WILLIAM04052005/Projet-Bateau-autopilot-2024-2026-/docs/rapports/annee-1_2024-2025/eee-synthese-simulations.pdf

# synthesis diagram and simulations of analog controls 1-SIMULATION OF MOTOR CONTROL

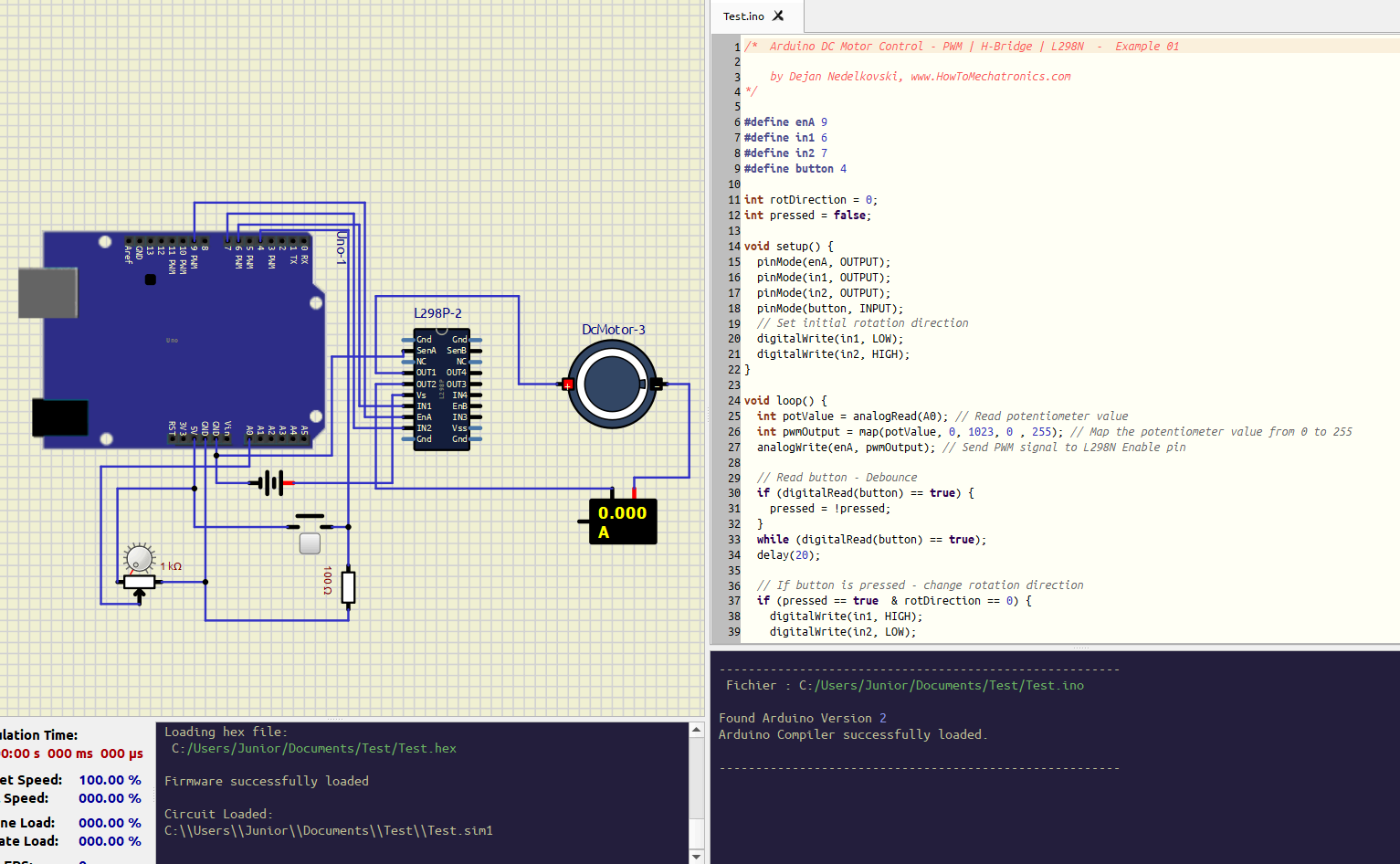
[picture p67: figure]
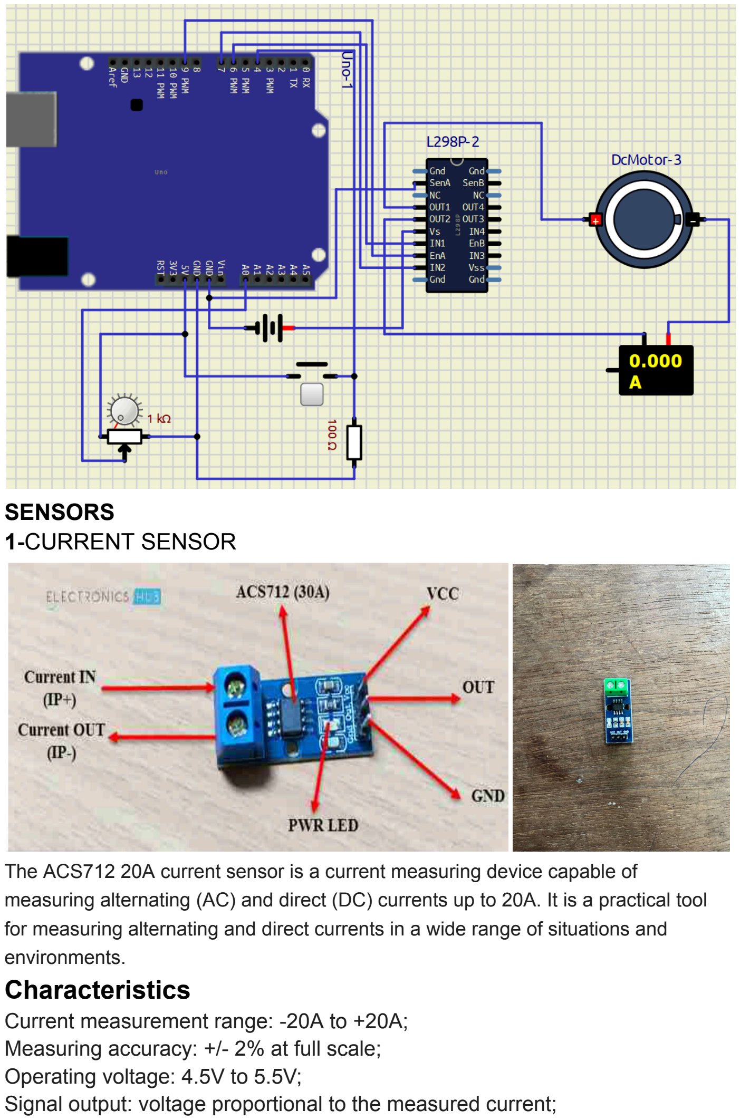
[picture p68: page 2]

SENSORS
1-CURRENT SENSOR

The ACS712 20A current sensor is a current measuring device capable of measuring alternating (AC) and direct (DC) currents up to 20A. It is a practical tool for measuring alternating and direct currents in a wide range of situations and environments.

## Characteristics

Current measurement range: -20A to +20A;
Measuring accuracy: +/- 2% at full scale;
Operating voltage: 4.5V to 5.5V;
Signal output: voltage proportional to the measured current;

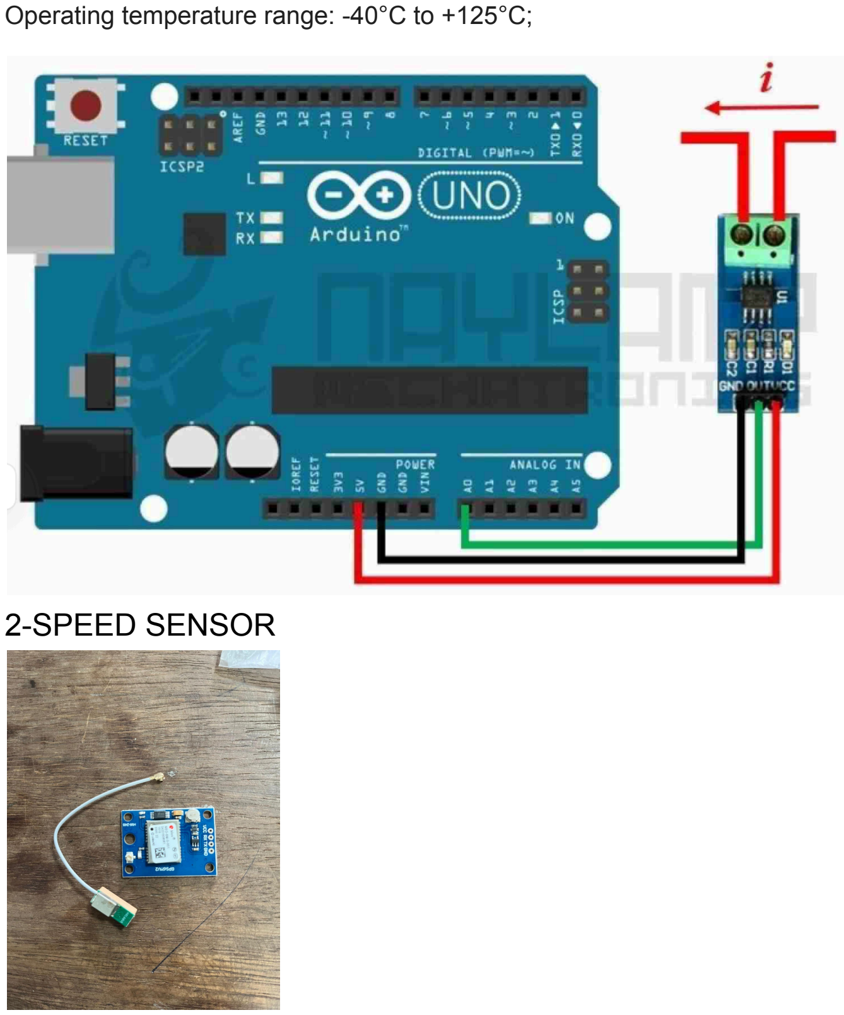
[picture p69: page 3]

Operating temperature range: -40°C to +125°C;

## 2-SPEED SENSOR
