WILLIAM04052005/Projet-Bateau-autopilot-2024-2026-/media/images/annee-1/eee-chaines-commande-information.jpg

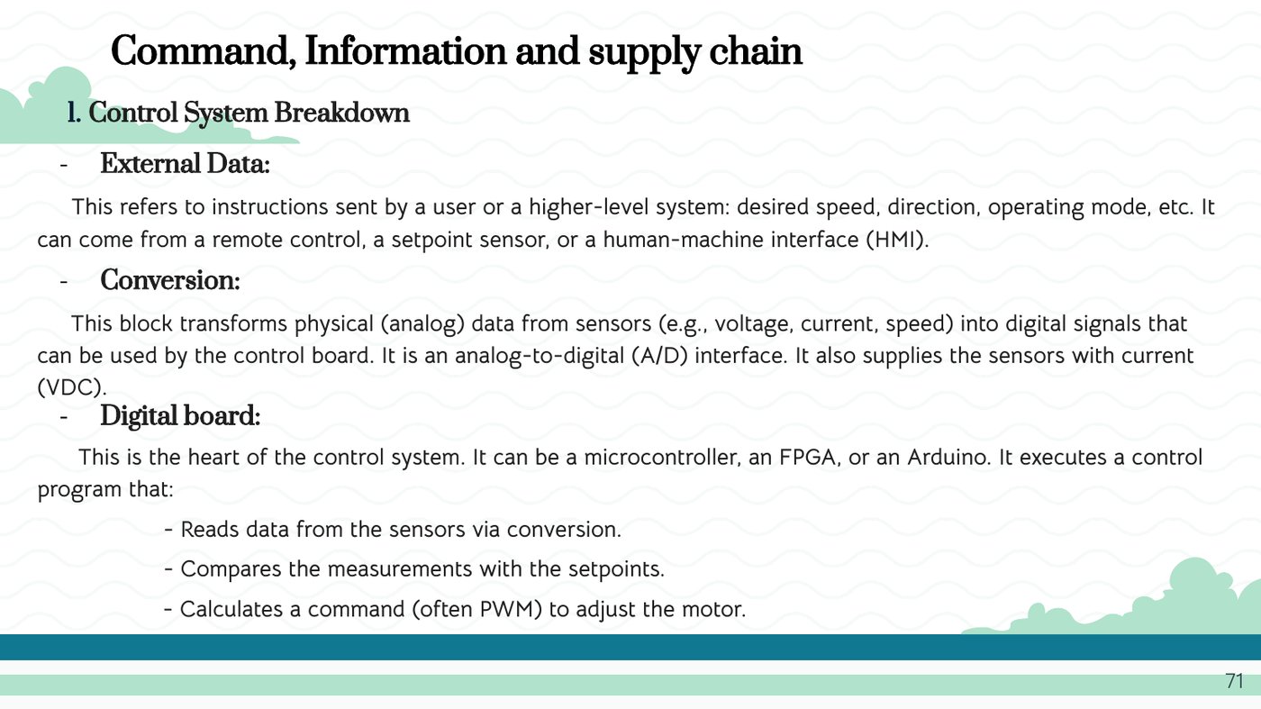
media/images/annee-1/eee-chaines-commande-information.jpg
