WILLIAM04052005/Projet-Bateau-autopilot-2024-2026-/media/images/annee-1/eee-systeme-automatise-arduino.jpg

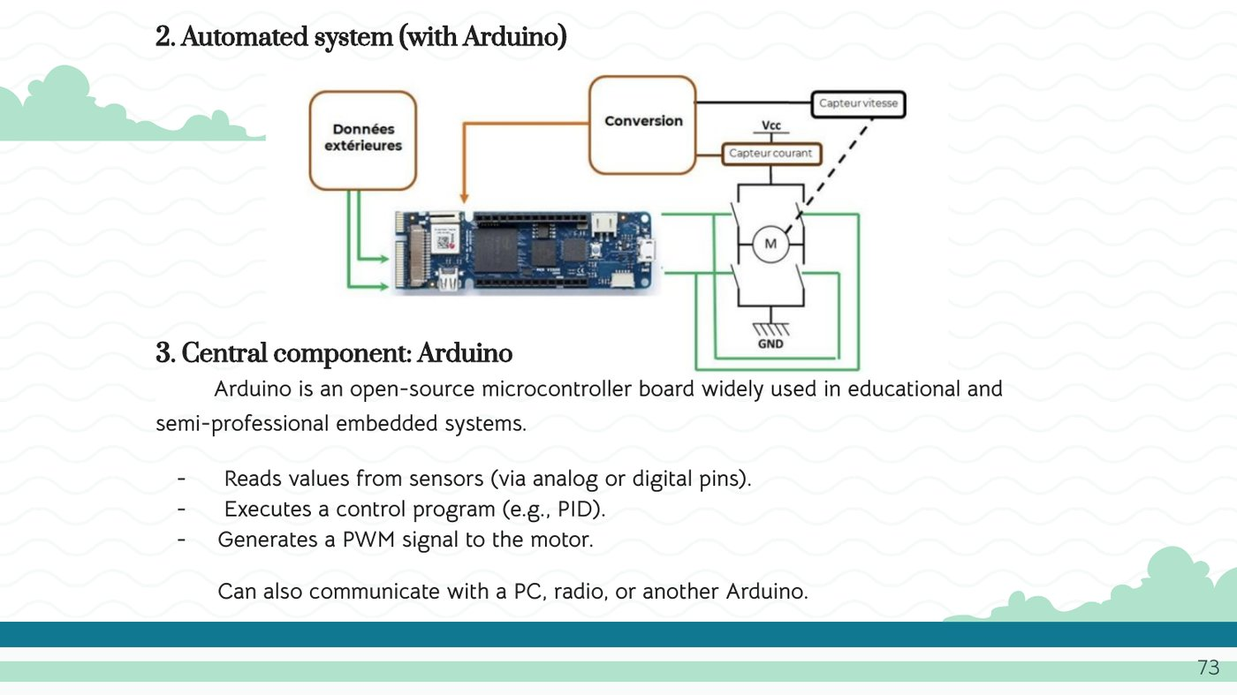
media/images/annee-1/eee-systeme-automatise-arduino.jpg
