WILLIAM04052005/Projet-Bateau-autopilot-2024-2026-/media/images/annee-1/mia-cablage-autopilote.jpg

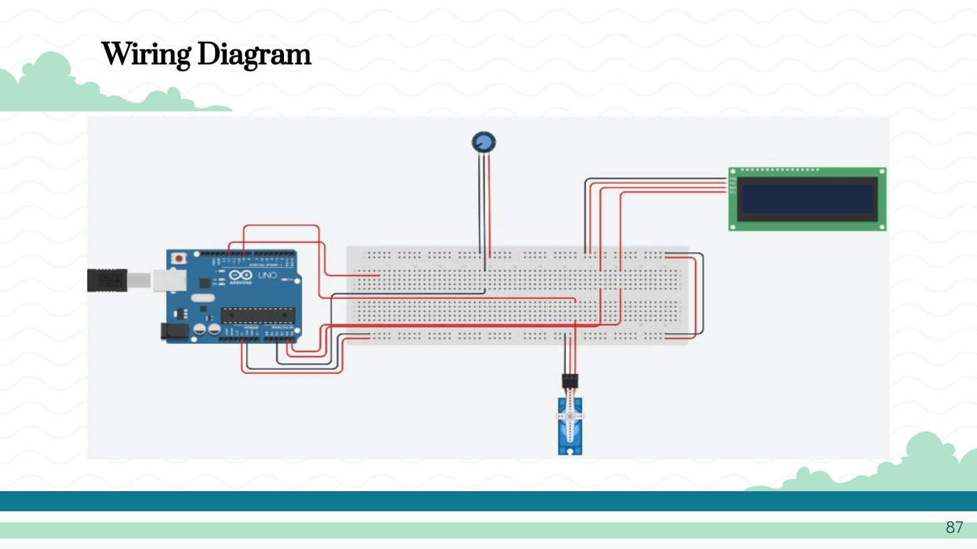
media/images/annee-1/mia-cablage-autopilote.jpg
