WILLIAM04052005/Projet-Bateau-autopilot-2024-2026-/media/images/annee-2/app-inventor-motor-direction.png

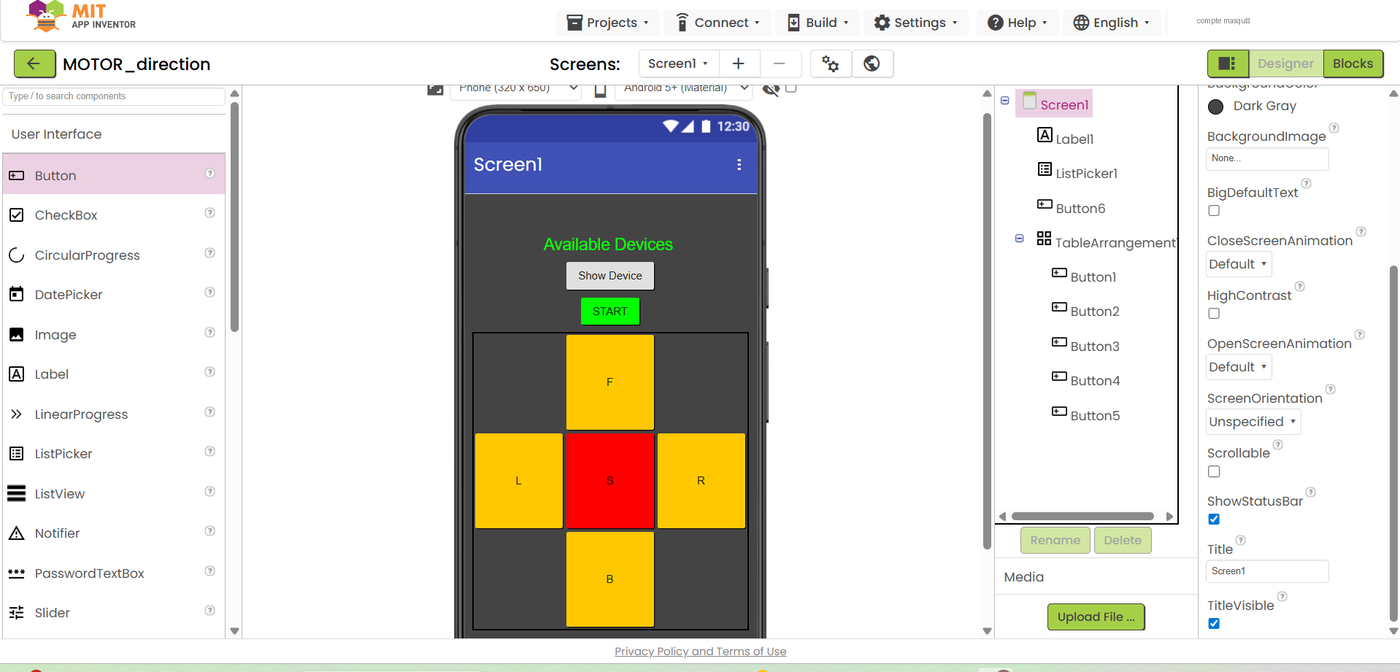
media/images/annee-2/app-inventor-motor-direction.png
