WILLIAM04052005/Projet-Bateau-autopilot-2024-2026-/media/images/annee-2/eee-blocs-fonctionnels.png

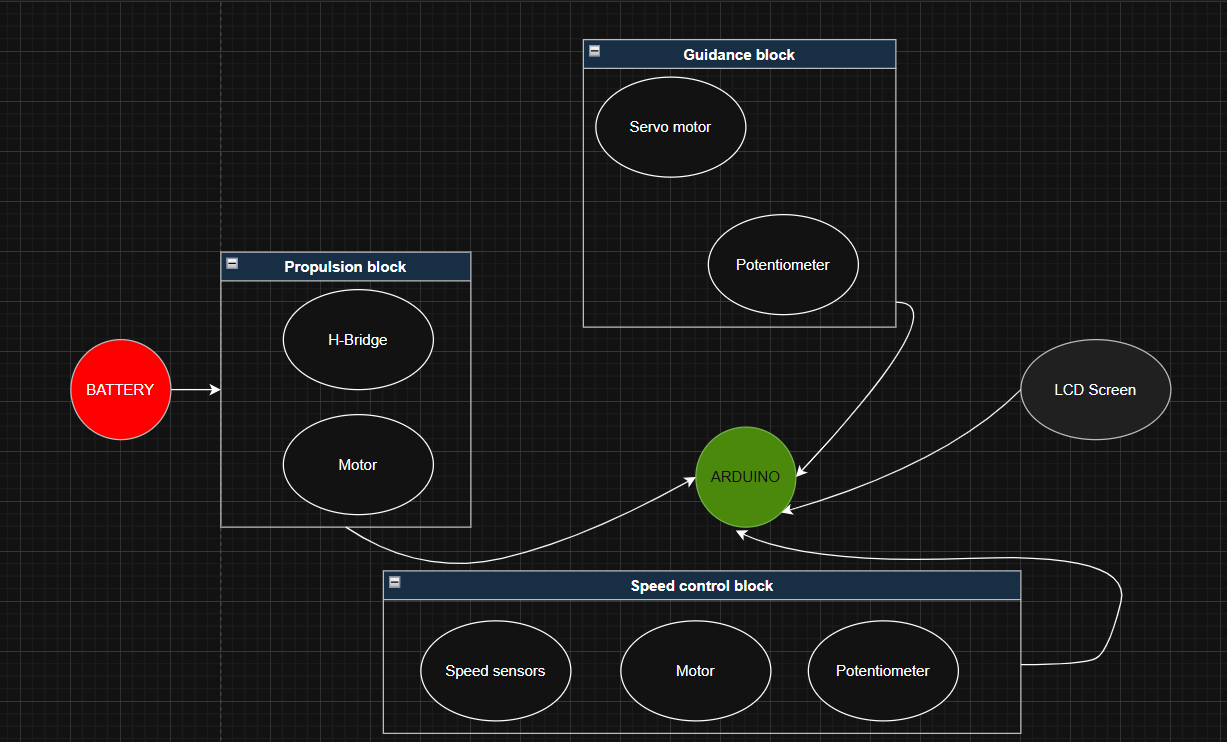
media/images/annee-2/eee-blocs-fonctionnels.png
