WILLIAM04052005/Projet-Bateau-autopilot-2024-2026-/media/images/annee-2/interface-web-reelle-2.png

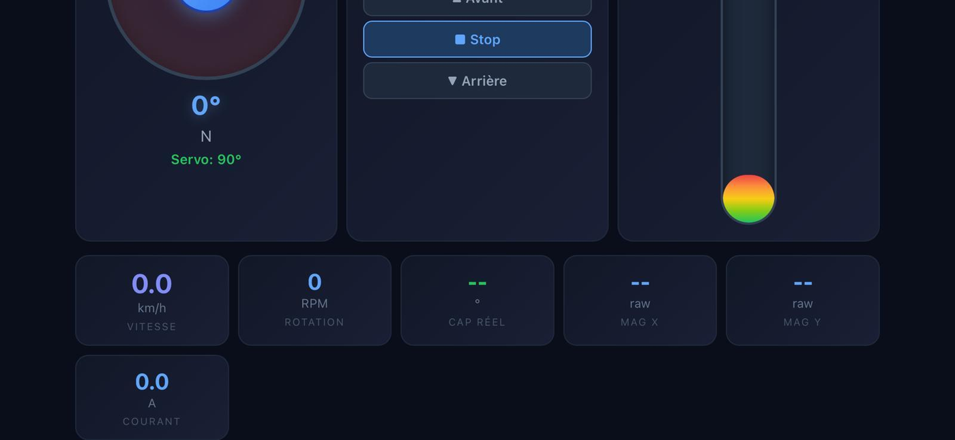
media/images/annee-2/interface-web-reelle-2.png
