WILLIAM04052005/Projet-Bateau-autopilot-2024-2026-/media/images/annee-2/moule-reutilise-potager.jpg

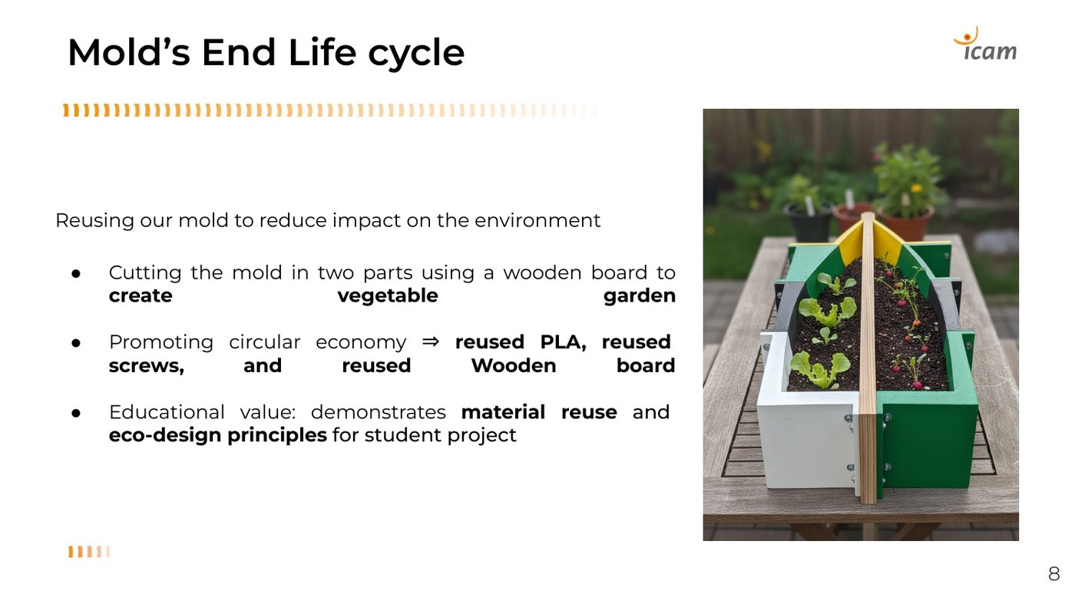
media/images/annee-2/moule-reutilise-potager.jpg
