WILLIAM04052005/Projet-Bateau-autopilot-2024-2026-/media/images/annee-2/pont-h-bts7960.jpg

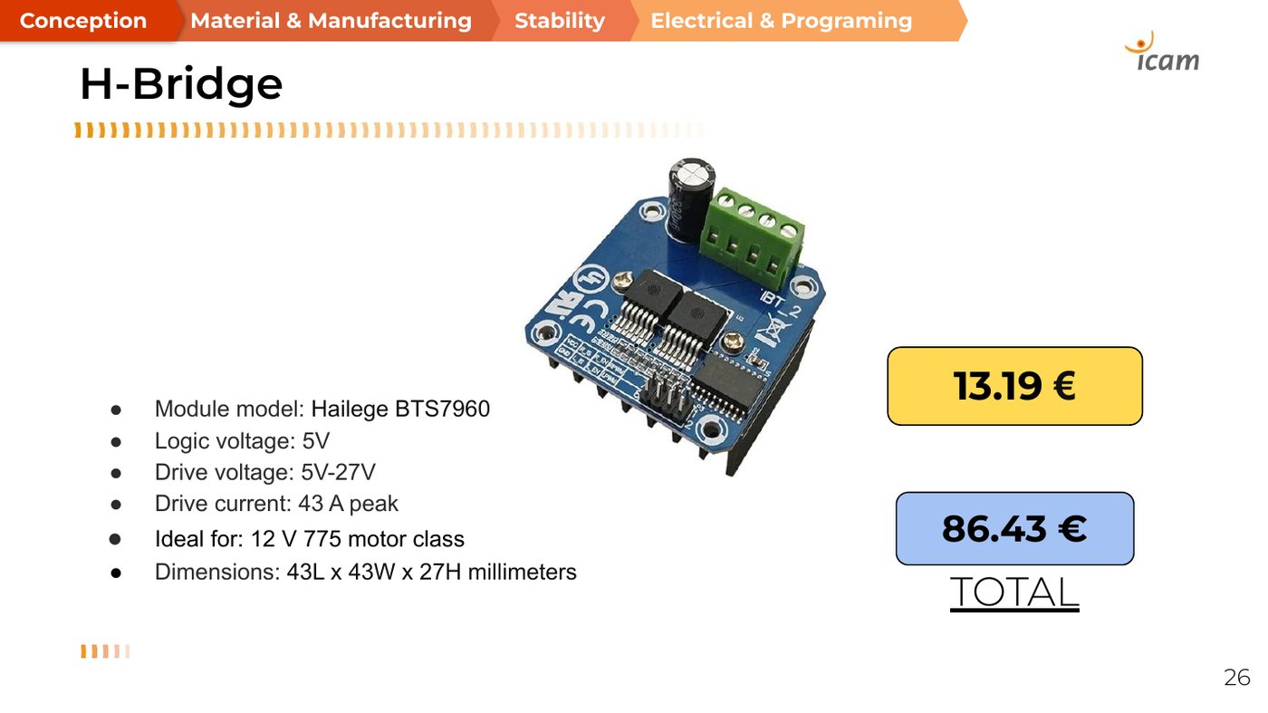
media/images/annee-2/pont-h-bts7960.jpg
