WILLIAM04052005/Projet-Bateau-autopilot-2024-2026-/media/photos/atelier-composite.jpg

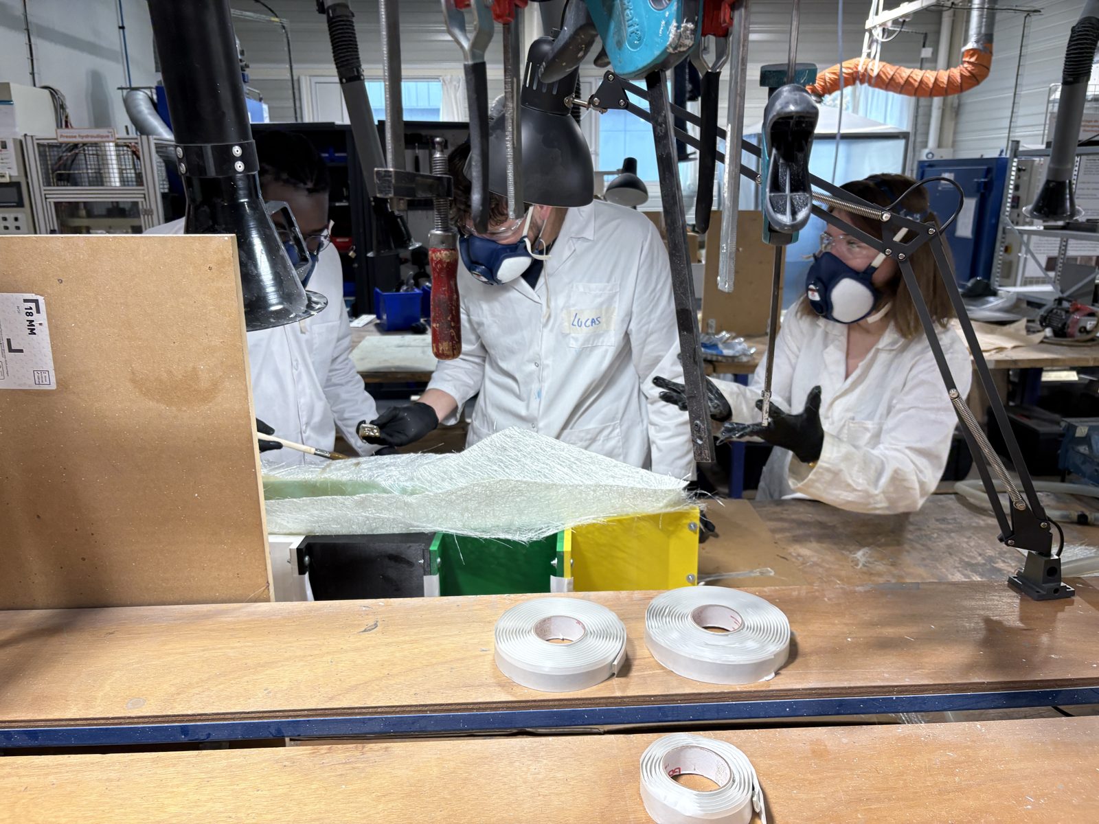
media/photos/atelier-composite.jpg
