WILLIAM04052005/Projet-Bateau-autopilot-2024-2026-/media/photos/coque-support-arriere.jpg

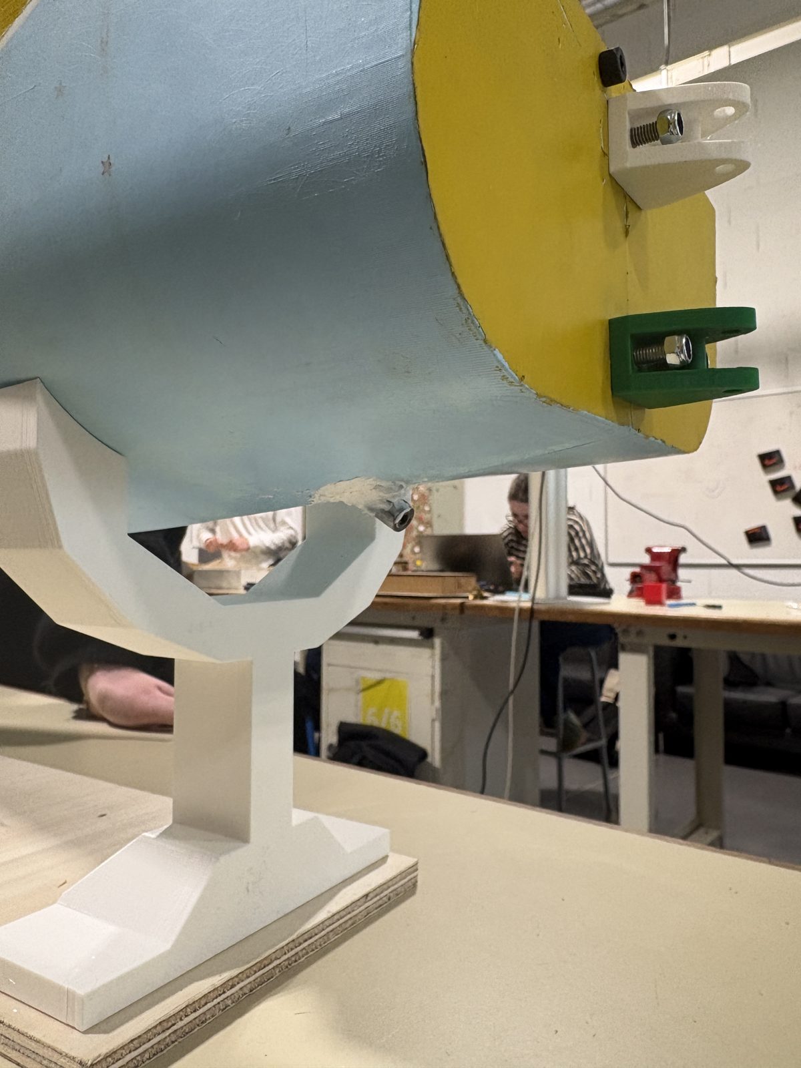
media/photos/coque-support-arriere.jpg
