WILLIAM04052005/Projet-Bateau-autopilot-2024-2026-/media/photos/interface-telephone.jpg

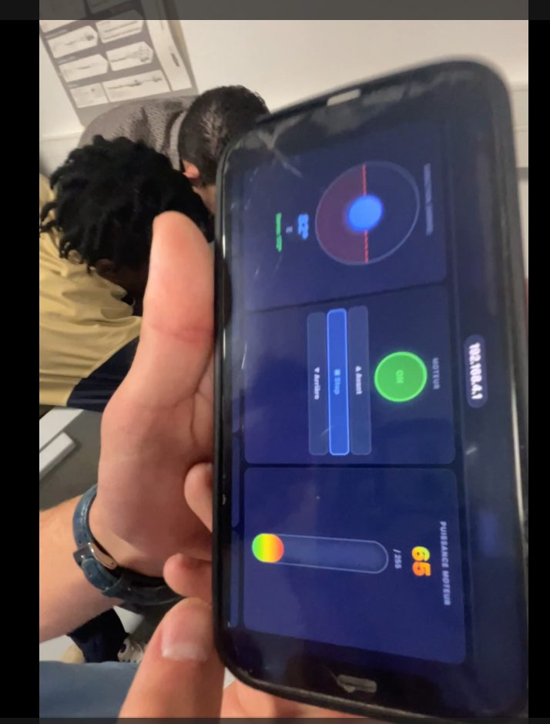
media/photos/interface-telephone.jpg
