WILLIAM04052005/Projet-Bateau-autopilot-2024-2026-/media/photos/stratification-4.jpg

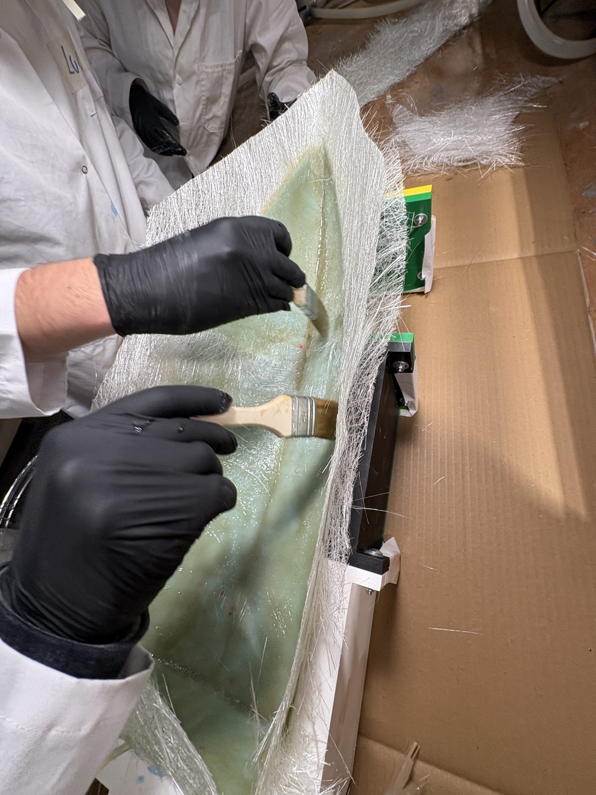
media/photos/stratification-4.jpg
