WILLIAM04052005/Projet-Bateau-autopilot-2024-2026-/media/photos/thermoformage-2.jpg

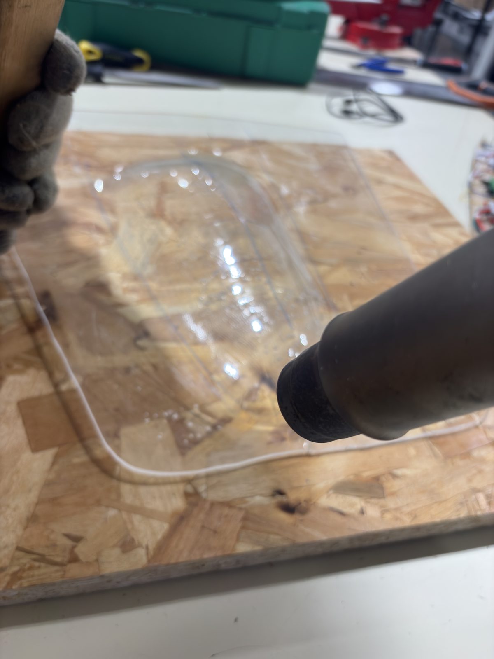
media/photos/thermoformage-2.jpg
