WILLIAM04052005/Projet-Bateau-autopilot-2024-2026-/docs/rapports/annee-2_2025-2026/pitch-fabrication.pdf

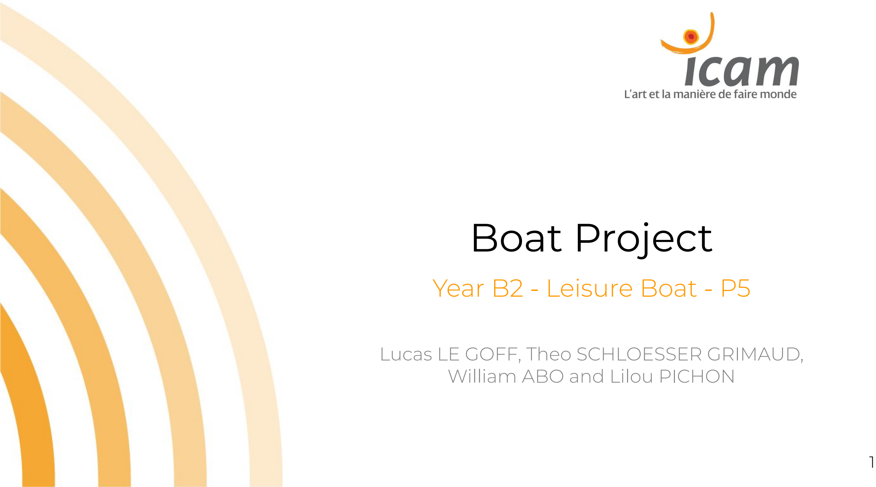
[picture p210: page 1]

# Boat Project

## Year B2 - Leisure Boat - P5

Lucas LE GOFF, Theo SCHLOESSER GRIMAUD, William ABO and Lilou PICHON

# Context

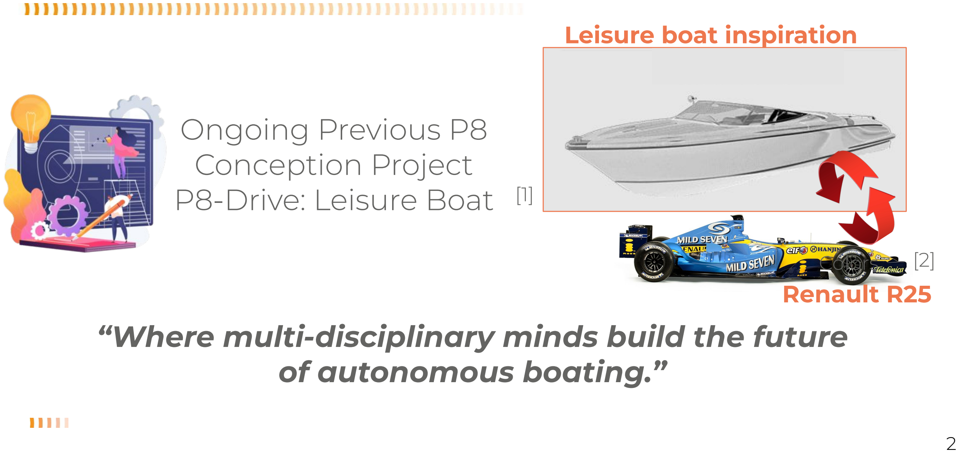
[picture p211: figure]
of autonomous boating.”; Ongoing Previous P8 Conception Project P8-Drive: Leisure Boat; Colors; Leisure boat inspiration; Renault R25

## “Where multi-disciplinary minds build the future

# Manufacturing process

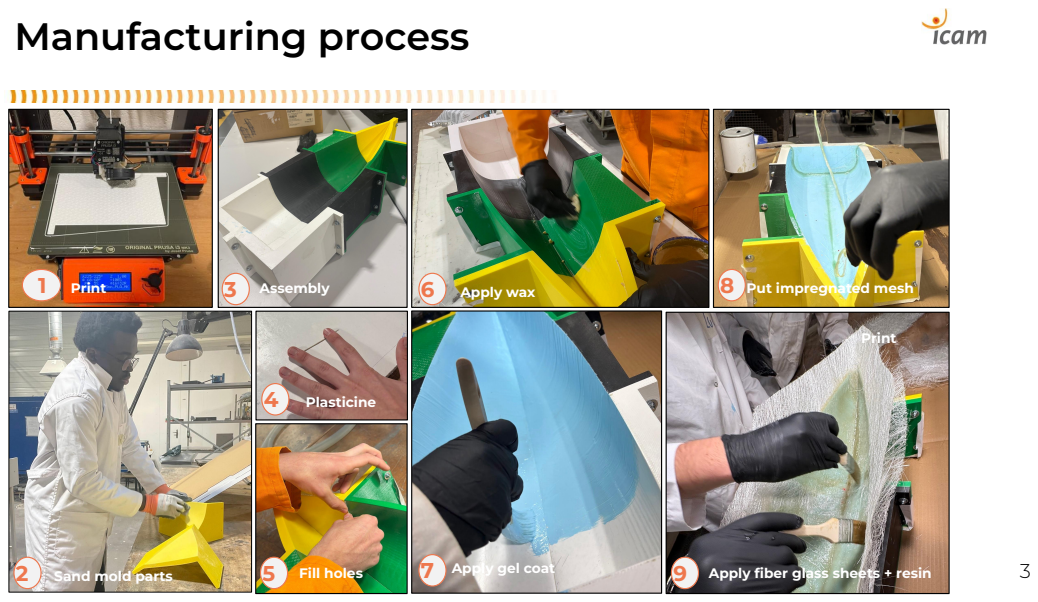
[picture p212: page 3]
Print; Assembly; Apply wax; Sand mold parts; Fill holes; Plasticine

Put impregnated mesh

Apply gel coat

Apply fiber glass sheets + resin

# Manufacturing progress

## Deck

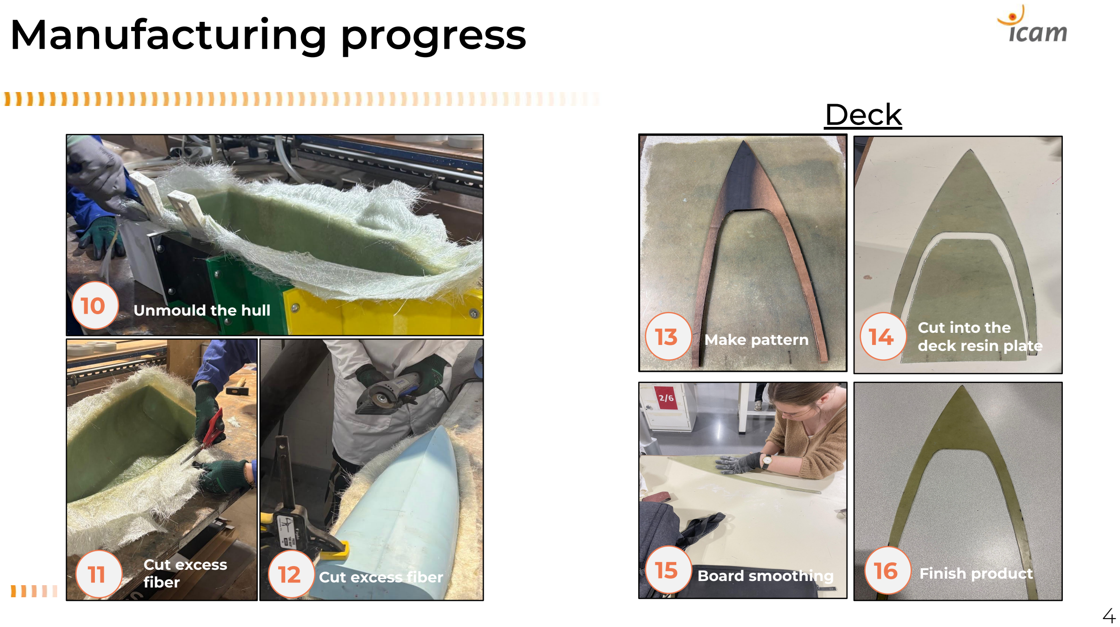
[picture p213: page 4]

10

11 12

13

15

14

Cut excess fiber | 16

Unmould the hull

Cut excess
fiber | Board smoothing

Cut into the
deck resin plate

Finish product

Make pattern

# Highlights of progress

## Exploded view

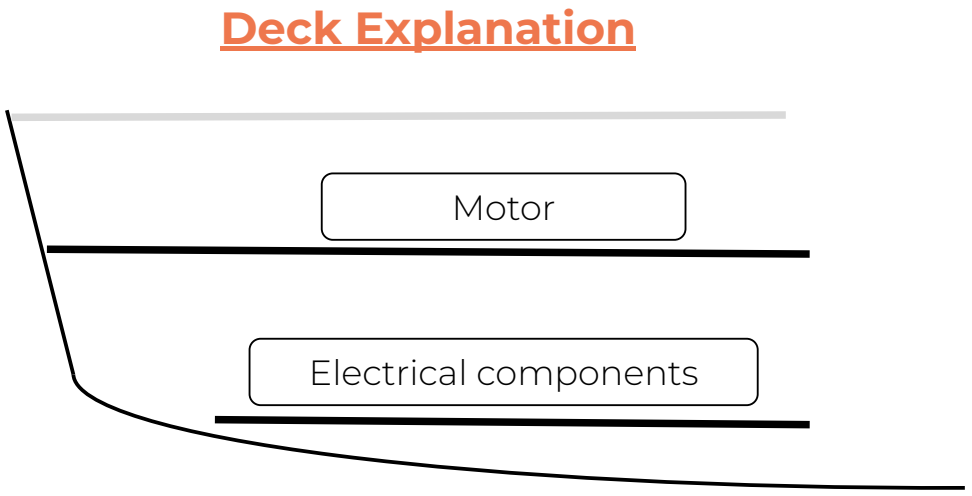
[picture p214: figure]
Electrical components; Motor; Deck Explanation
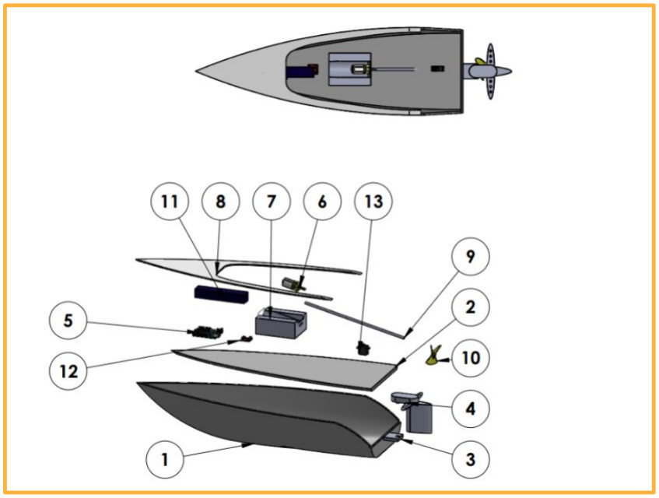
[picture p215: figure]

# Highlights of progress

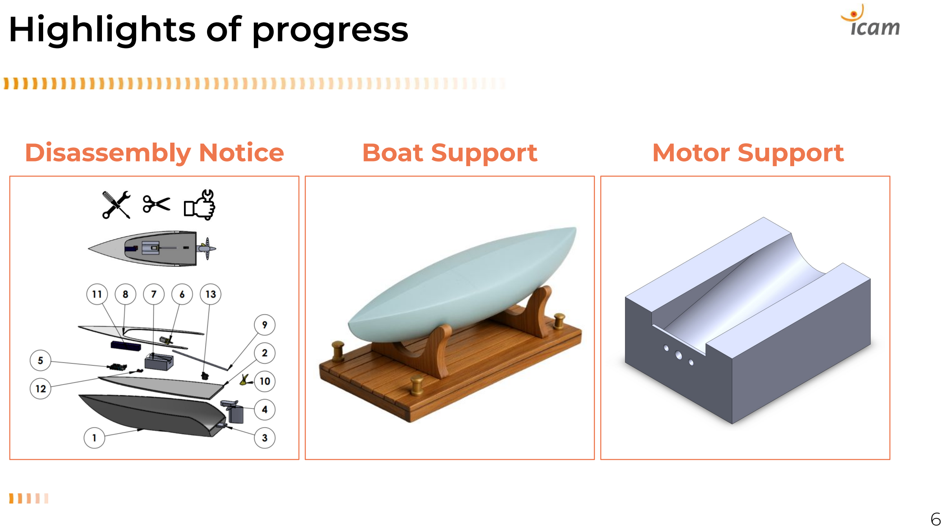
[picture p216: page 6]

Disassembly Notice | Boat Support | Motor Support

# Second semester plan

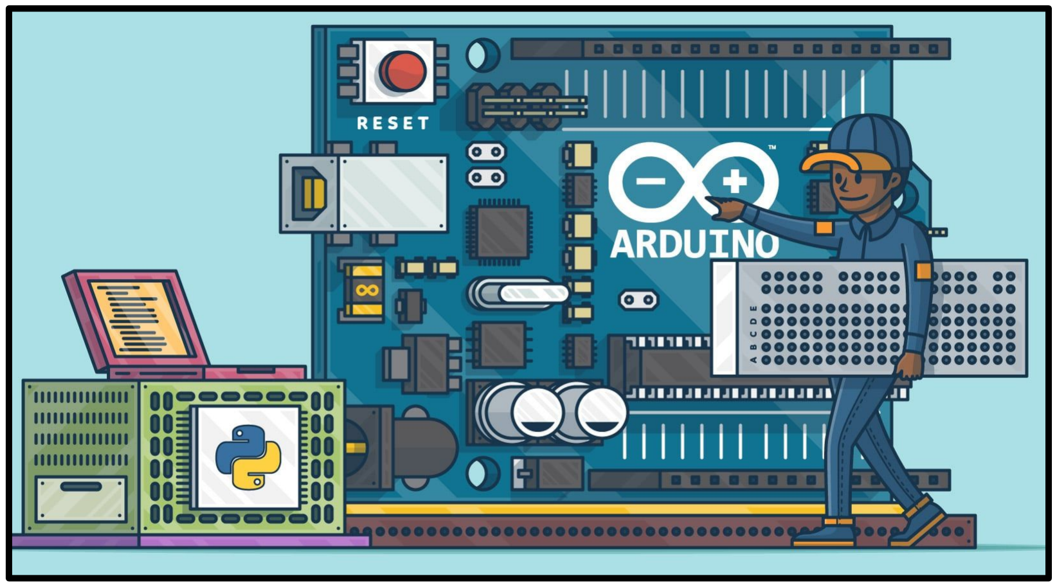
[picture p217: figure]

### Programmation part

- Develop the boat’s control system
- Integrate sensors and process navigation data

### Assembly and motorisation part

- Positioning, securing the motor with screw and drive shaft.
- Installing the battery, sensors and all components
- Checking proper functioning and conducting operational tests.

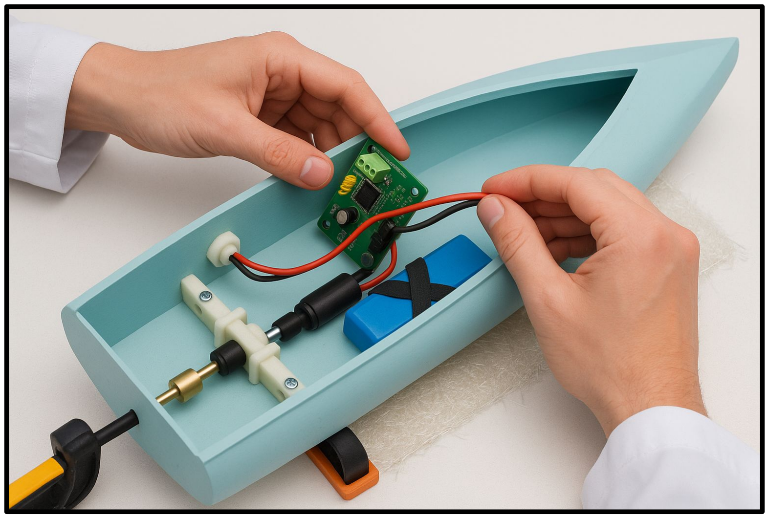
[picture p218: figure]

### Environmental part

- Life Cycle Analysis

# Mold’s End Life cycle

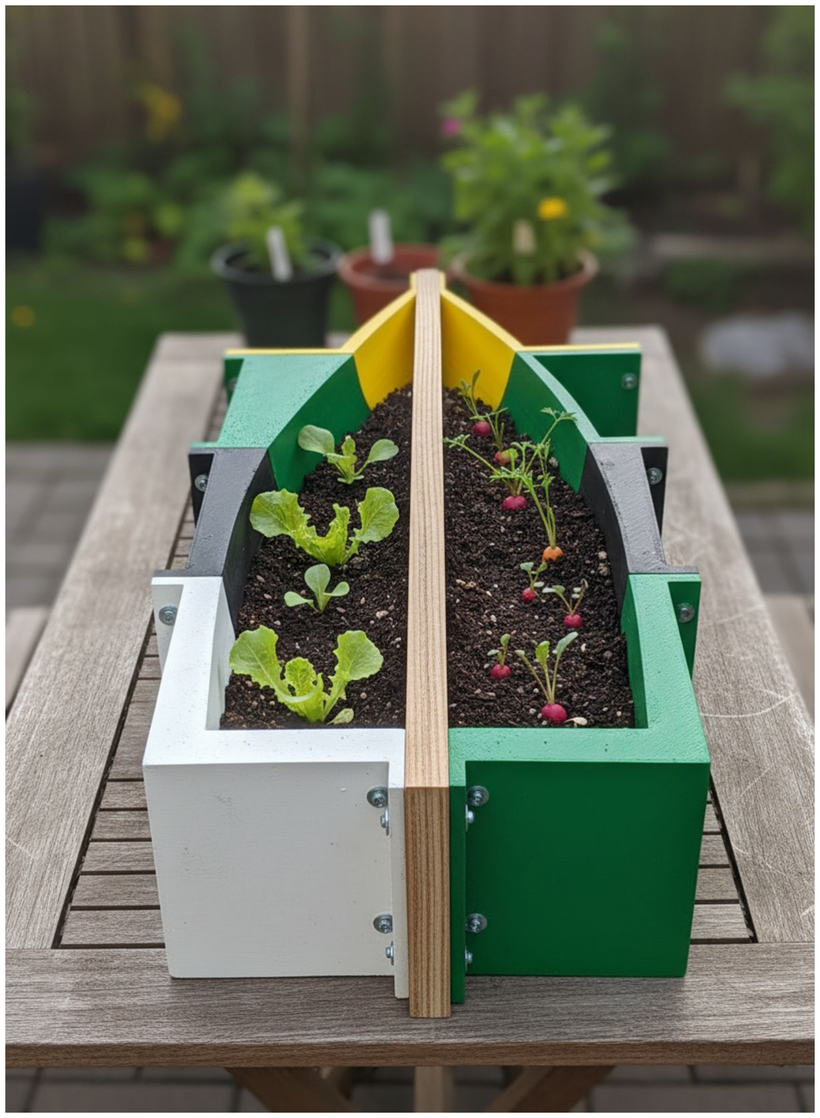
[picture p219: figure]

Reusing our mold to reduce impact on the environment

- Cutting the mold in two parts using a wooden board to
create | | vegetable | | garden
- Promoting circular economy ⇒ reused PLA, reused
screws, | and | reused | Wooden | board
- Educational value: demonstrates material reuse and eco-design principles for student project

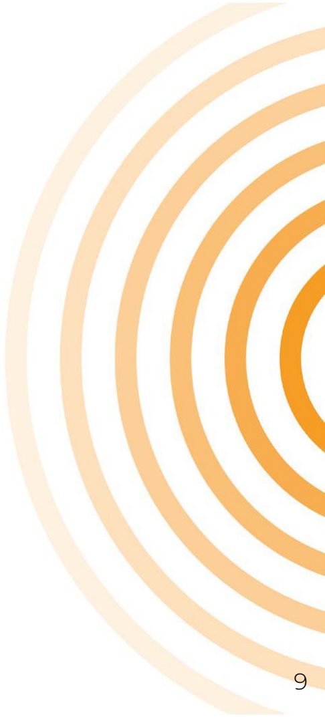
[picture p220: figure]

# Thank you !
