WILLIAM04052005/Projet-Bateau-autopilot-2024-2026-/media/photos/classe-test-mare.jpg

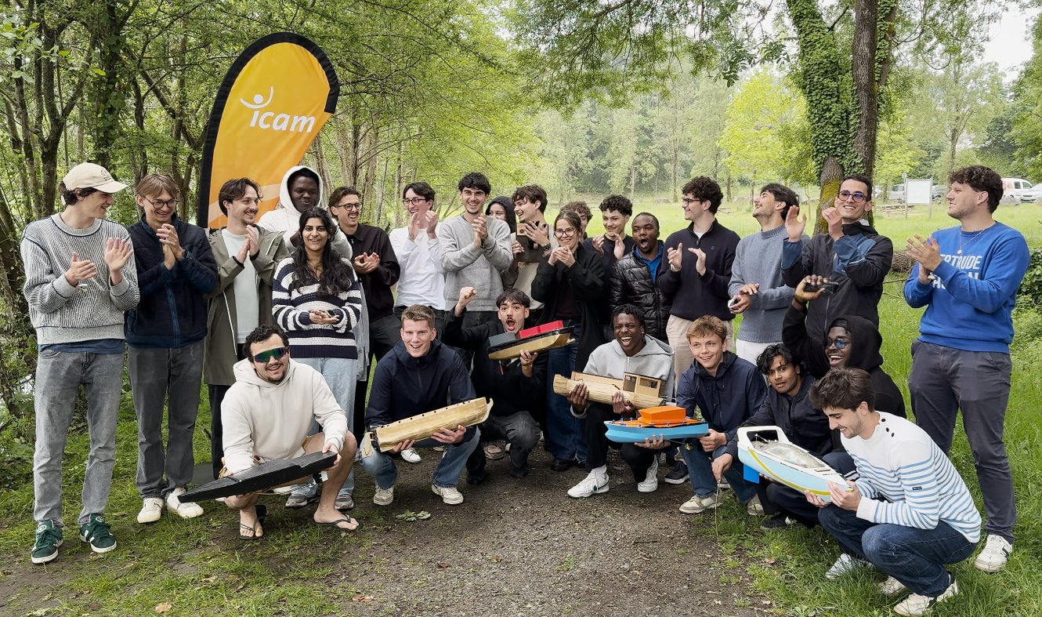
media/photos/classe-test-mare.jpg
