WILLIAM04052005/Projet-Bateau-autopilot-2024-2026-/tests/annee-1_2024-2025/01_pont_h_double_moteur/01_pont_h_double_moteur.ino

int IN1 = 12; 
int IN2 = 11; 
int IN3 = 7;
int IN4 = 6;

void setup()
{
  pinMode(IN1, OUTPUT);
  pinMode(IN2, OUTPUT);
  pinMode(IN3, OUTPUT);
  pinMode(IN4, OUTPUT);

  Serial.begin(9600);
  Serial.println("Enter number for control option:");
  Serial.println("1. FORWARD");
  Serial.println("2. REVERSE");
  Serial.println("3. STOP");
  Serial.println();  
}

void loop()
{
  char user_input;
  
  while(Serial.available())
  {
    user_input = Serial.read();
    digitalWrite(IN1, LOW); //OFF
    digitalWrite(IN2, LOW);

    if (user_input =='1')
    {
       Forward();
    }
    else if(user_input =='2')
    {
      Reverse();
    }
    else if(user_input =='3')
    {
      Stop();
    }
    else
    {
      Serial.println("Invalid option entered.");
    }
  }
}


void Forward()
{
  digitalWrite(IN1, HIGH);
  digitalWrite(IN2, LOW);
  Serial.print("Motor 1 Forward");
  Serial.println();
  
  digitalWrite(IN3, HIGH);
  digitalWrite(IN4, LOW);  
  Serial.println("Motor 2 Forward");
  Serial.println();
}

void Reverse()
{
  digitalWrite(IN1, LOW); 
  digitalWrite(IN2, HIGH);
  Serial.print("Motor 2 Reverse");
  Serial.println();
  
  digitalWrite(IN3, LOW); 
  digitalWrite(IN4, HIGH);
  Serial.println("Motor 2 Reverse");
  Serial.println();
}

void Stop()
{
    digitalWrite(IN1, LOW);
    digitalWrite(IN2, LOW);
    Serial.print("Motor 1 Stop");
    Serial.println();
    
    digitalWrite(IN3, LOW);
    digitalWrite(IN4, LOW);
    Serial.println("Motor 2 Stop");
    Serial.println();

}
